veresgyuri/fanoe-tester/images/20260712_092536.jpg

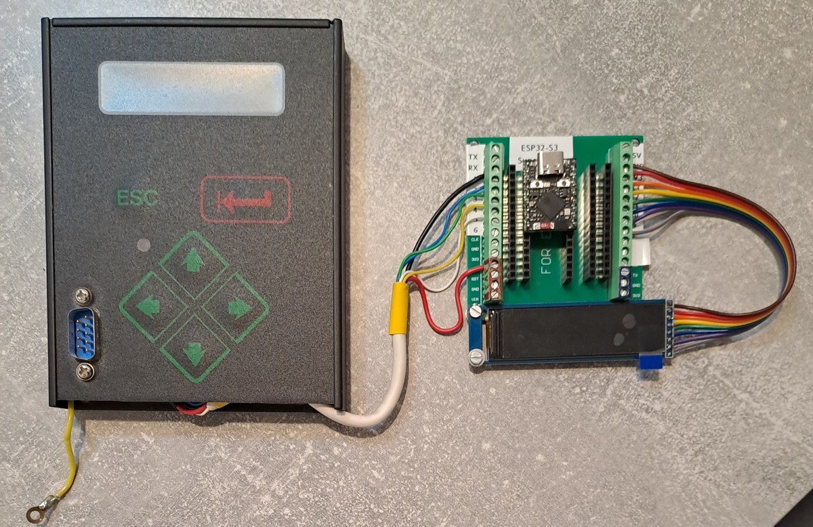
images/20260712_092536.jpg
