veresgyuri/fanoe-tester/images/pin_esp32_s3_super_mini.jpg

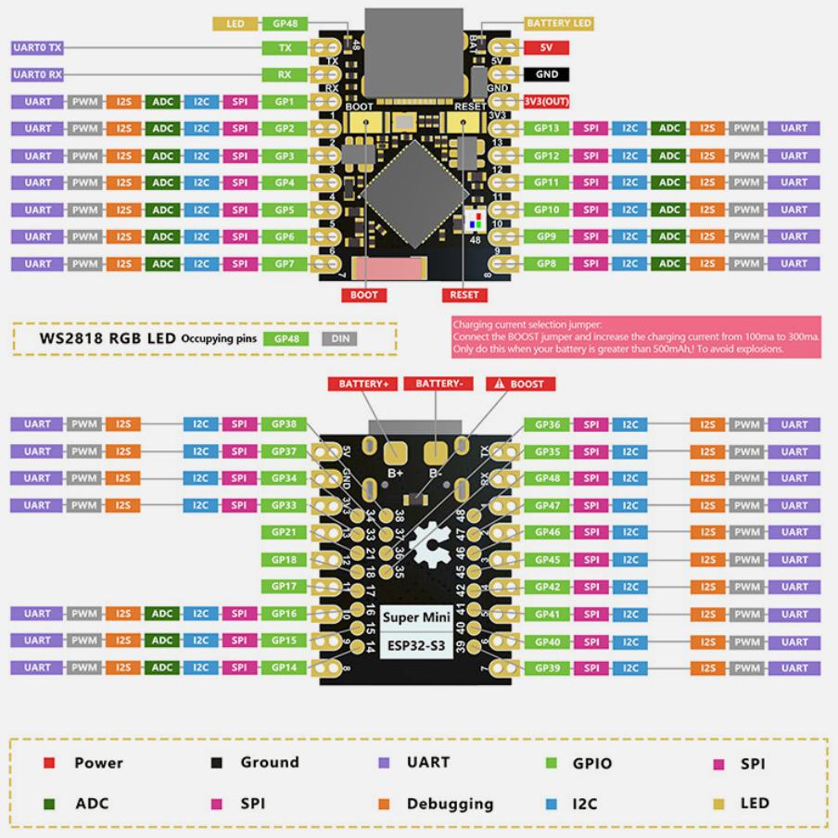
images/pin_esp32_s3_super_mini.jpg
