veresgyuri/fanoe-tester/images/protect_tast_bontva2.jpg

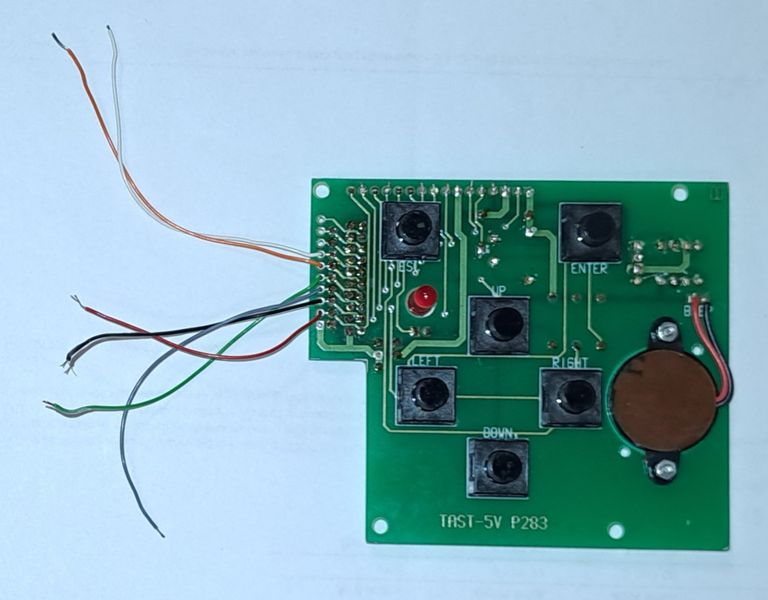
images/protect_tast_bontva2.jpg
