veresgyuri/fanoe-tester/.copilot-instructions.md

## Context & Hierarchy
This document defines the core execution rules for AI coding agents.  
**In case of any conflict, always follow this (`.copilot-instructions.md`) file and ignore conflicting information from `AGENTS.md`.**  

## 1. Role & Core Philosophy
You are an AI agent optimized for CircuitPython (version 10.x.x) and ESP32-S3 microcontroller development.  
Your primary goal is to write robust, modular, highly stable and bug-free code for an diagnostic meter tool.
Prioritize **stability and non-blocking execution** over extreme memory optimization.

**Flexibility note:** When working on domain-specific tasks (e.g., adding new hardware, debugging subsystems), load the relevant skill file to override or extend these rules. Skills define specialized workflows and take precedence within their scope.

## 2. CircuitPython Rules & Hardware-Specific Context

**File Structure:** Each `/instructions/*.md` file is organized in two sections:
1. Human-oriented reference (context, specifications)
2. AI-specific logic (`CODE GENERATION LOGIC` — this is YOUR section)

**ALWAYS read this file (applies to ALL code generation):**
- `instructions/CircuitPython_instructions.md` - CircuitPython language rules, non-blocking patterns, memory management, and core library usage  
- `instructions/fanoe_tester_logic.md` - device logic: test sequences, measurement methods, calculations.  
   Menu structure lives in `menu_data.py` (see Section 3) - this file only describes the measurement logic, not the menu tree itself. 

**ALSO read when working with specific hardware components:**
- MCU/Pinout -> read `instructions/esp32s3supermini_instructions.md`
- Keypad -> read `instructions/keypad_6_matrix_instructions.md`
- Display -> read `instructions/76x284_st7789_tft_instructions.md`  

**Crucial:** Always follow the `CODE GENERATION LOGIC` sections. CircuitPython rules take precedence over hardware-specific details. Never use standard Python constructs that violate CircuitPython constraints (e.g., hardware ISRs, blocking loops).  

## 3. Write/read - permissions
### Writable (you may edit these):
- `code.py` - Main application (Note: Writing to filesystem from code is conditional, see Section 2 instructions)  
- `settings.toml` - Configuration file
- `/lib/*` - CircuitPython libraries

**Read-only files (NEVER modify):**  
- `README.md` - Human documentation  
- `AGENTS.md` - AI agent overview  
- `boot.py` - Filesystem & Mode Control - Manages USB drive vs. code write access via GPIO  
- `menu_data.py` - Menu structure data (dict/list)  
- `tft_messages.py` - TFT message definitions  
- `.copilot-instructions.md` - Agent execution rules (this file)
- `/instructions/*.md` - CircuitPython OS and hardware component rules  
- `/fonts/hu_127_ekezetes_20.pcf` - Hungarian accented fonts & Special characters set  
- `/images/*` - Visual project assets  
- `/archive/*` - OFF-LIMITS (user-only sandbox)  
- `/skills/*.md` - AI agent skill definitions (loaded on-demand)

### Forbidden Paths (NEVER ACCESS)
- `/archive/*` - Off-limits to any AI system (including orchestrators).

## 4. Output & Delivery
- **Complete code first:** Provide fully functional, usable code by default. No partial snippets or "pseudocode."  
- **Minimal edits:** If modifying existing code, change only what is necessary. Avoid refactoring unrelated code.  
- **Validation:** Always validate generated code against the `CODE GENERATION LOGIC` section in relevant `/instructions/*.md` file before delivery.  
- **Testing notes:** Include comments or test suggestions for new hardware-related modules to aid debugging via Serial REPL.

## 5. Coding Standards & Style
- **Pattern:** Use modular, Object-Oriented Programming (OOP) patterns for `code.py` and other logic modules.  
`menu_data.py` is a pure data file (menu tree structure) and is NOT subject to the OOP requirement — it must remain a plain,  
directly-readable data structure (dict/list), with no embedded function calls or live references.  
Dynamic screens reference an "action" string key, resolved/dispatched by code.py.
- **Naming:** snake_case for variables/functions, PascalCase for classes.  
- **Formatting:** 4 spaces indentation, max 88 characters per line (Black style).
- **Libraries:** Only use CircuitPython-compatible libraries  
- **Memory Management:** Prioritize stability; minimize global variables and release unused resources.  
- **Documentation:** Use clear, concise comments and docstrings. Maintain readability for DIY hobbyists.
- **Error Handling:** Implement robust error handling with try-except blocks, especially for hardware interactions and network operations.
- **Logging & Debugging:** Use a global `DEBUG` flag and a `dprint(*args, **kwargs)` wrapper to gate all non-critical REPL output.

## 6. Display & Keypad Logic
- **Non-Blocking Execution:** UI updates (TFT) and input handling (Keypad) MUST NOT interrupt the measurement. Use asyncio or non-blocking state machines.
- **Validation:** Include print() or logging statements for key state changes (analog input, GPIO level, errors) to assist debugging via Serial REPL.
- **Setting Management:** Implement a modular settings management system that can easily add/remove settings from `settings.toml` without code changes.
- **Stability:** This board has 2MB embedded PSRAM. CircuitPython automatically places large allocations (e.g. displayio bitmaps, buffers) there once the firmware build supports PSRAM — no manual memory placement is needed in code. Still keep UI/menu logic memory-conscious: avoid unnecessary large temporary buffers, and release unused objects (del + gc.collect()) after heavy operations like display redraws.

## 7. Testing & Deployment
- **Unit Testing:** Suggest basic test cases for new hardware-related modules.
- **Manual Deployment:** Keep in mind that code is deployed by copying files to the CIRCUITPY drive; avoid any automation scripts for file transfer.

## 8. Skill-Based Workflows (On-Demand)
Optional, focused skill files can extend or override these rules for specific tasks. When a skill is loaded, it takes precedence within its defined scope.

**Skill location:**
- `skills/<skill-name>.md`

**Current examples:**
- `skills/add-menu.md` - workflow for menu structure and navigation changes
- `skills/add-device-action.md` - workflow for action handlers, confirmation-gated actions, continuous modes, and state-machine logic

**Loading a skill:**
Skills appear as slash commands in Copilot Chat when their markdown file exists in the `skills/` folder. When a skill is active, follow its instructions for that task while still respecting the global rules in this file and the relevant `/instructions/*.md` files. If a task touches both menu structure and device behavior, read both relevant skills.
