veresgyuri/fanoe-tester/images/fanoe_tester_logic_1v0.jpg

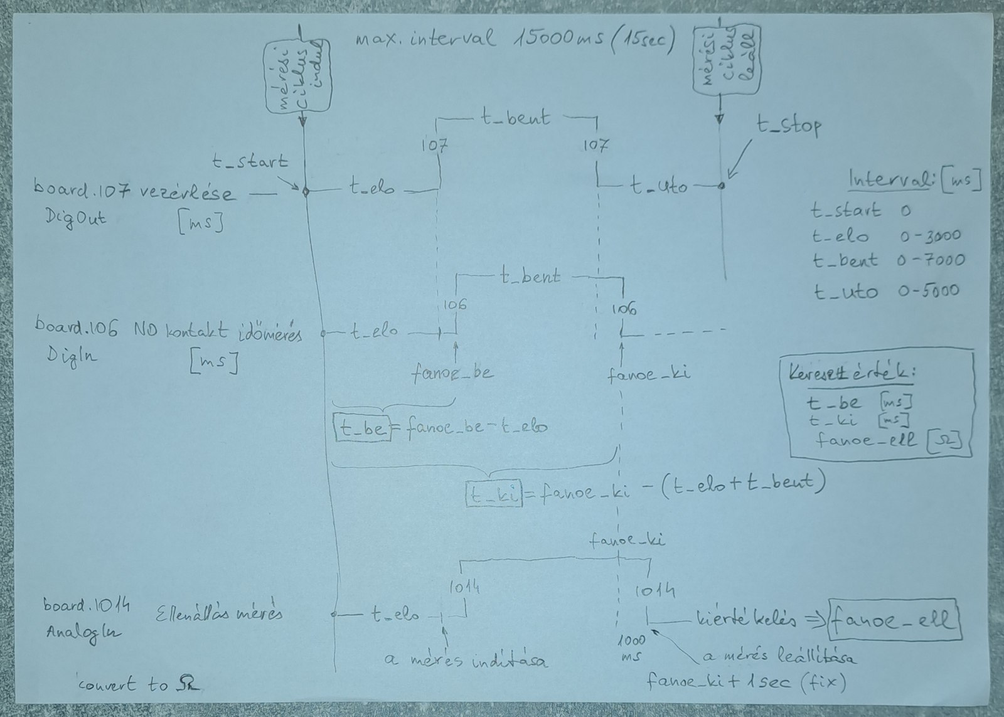
images/fanoe_tester_logic_1v0.jpg
