veresgyuri/fanoe-tester/KiCad/FANOE_tester_1v0.kicad_pcb

## KiCad design KiCad/FANOE_tester_1v0.kicad_pcb (2026-09-26)

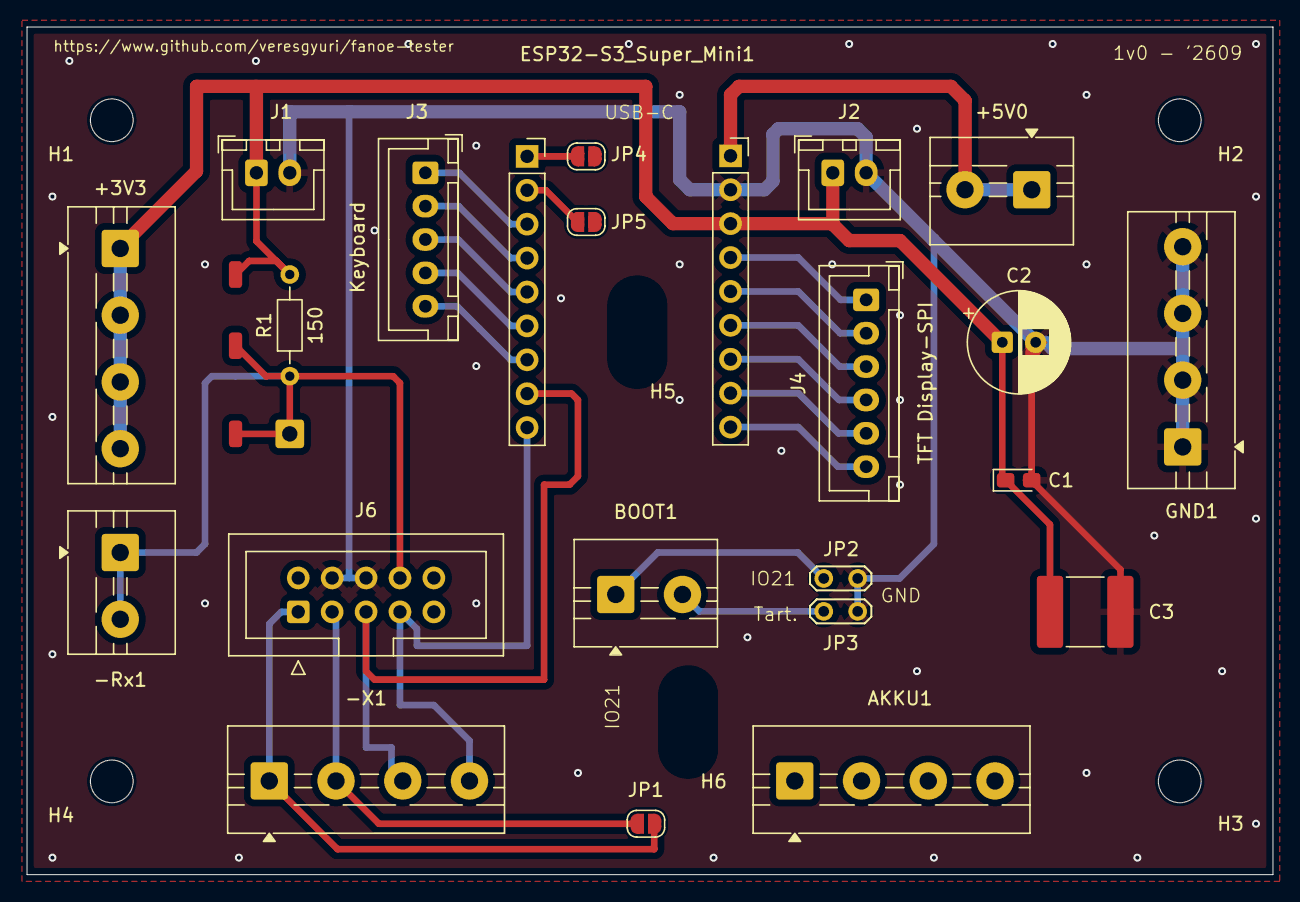
[picture p14: board FANOE_tester_1v0.kicad_pcb from above]

Board: 2 copper layers, 93.3 x 63.5 mm, 33 parts (0 on the bottom side), 23 nets.

Parts:
+3V3: Screw_Terminal_01x04; TerminalBlock_MaiXu_MX126-5.0-04P_1x04_P5.00mm
+5V0: Screw_Terminal_01x02; TerminalBlock_MaiXu_MX126-5.0-02P_1x02_P5.00mm
-Rx1: Screw_Terminal_01x02; TerminalBlock_MaiXu_MX126-5.0-02P_1x02_P5.00mm
-X1: Screw_Terminal_01x04; TerminalBlock_MaiXu_MX126-5.0-04P_1x04_P5.00mm
AKKU1: Screw_Terminal_01x04; TerminalBlock_MaiXu_MX126-5.0-04P_1x04_P5.00mm
BOOT1: Screw_Terminal_01x02; TerminalBlock_MaiXu_MX126-5.0-02P_1x02_P5.00mm
C1: C_Polarized_Small; CP_EIA-2012-12_Kemet-R_HandSolder
C2: CP_Radial_D7.5mm_P2.50mm
C3: C_Small; C_2220_5750Metric_Pad1.97x5.40mm_HandSolder
ESP32-S3_Super_Mini1, ESP32-S3_Super_Mini2: Conn_01x09; PinSocket_1x09_P2.54mm_Vertical
GND1: Screw_Terminal_01x04; TerminalBlock_MaiXu_MX126-5.0-04P_1x04_P5.00mm
H1, H2, H3, H4, H5, H6: MountingHole_3.2mm_M3
J1, J2: Conn_01x02; JST_XH_B2B-XH-A_1x02_P2.50mm_Vertical
J3: Keyboard; JST_XH_B5B-XH-A_1x05_P2.50mm_Vertical
J4: TFT Display-SPI; JST_XH_B6B-XH-A_1x06_P2.50mm_Vertical
J6: Conn_02x05_Odd_Even; IDC-Header_2x05_P2.54mm_Vertical
JP1, JP4, JP5: SolderJumper_2_Open; SolderJumper-2_P1.3mm_Open_RoundedPad1.0x1.5mm
JP2, JP3: Jumper_2_Open; TestPoint_2Pads_Pitch2.54mm_Drill0.8mm
Ohm1: SolderWire-0.5sqmm_1x01_D0.9mm_OD2.1mm
Ohm2, Ohm3, Ohm4: SolderWirePad_1x01_SMD_1x2mm
R1: 150; R_Axial_DIN0204_L3.6mm_D1.6mm_P7.62mm_Horizontal

Connections:
-3V3: +3V3.1, +3V3.2, +3V3.3, +3V3.4, C1.1, C2.1, C3.1, ESP32-S3_Super_Mini2.3 (+3V3-), J1.1, J2.1, Ohm4.1, R1.2
GND: C1.2, C2.2, C3.2, ESP32-S3_Super_Mini2.2 (GND-), GND1.1, GND1.2, GND1.3, GND1.4, J1.2, J2.2, J6.4, J6.6, JP2.2 (B), JP3.2 (B)
unnamed: +5V0.1, +5V0.2, ESP32-S3_Super_Mini2.1 (+5V-)
unnamed: -Rx1.1, -Rx1.2, J6.8, Ohm1.1, Ohm2.1, Ohm3.1, R1.1
unnamed: -X1.1, J6.1, JP1.2 (B)
unnamed: -X1.2, J6.3, JP1.1 (A)
unnamed: -X1.3, ESP32-S3_Super_Mini1.8 (-IO6), J6.5
unnamed: -X1.4, ESP32-S3_Super_Mini1.9 (-IO7), J6.7
unnamed: BOOT1.1, JP2.1 (A)
unnamed: BOOT1.2, JP3.1 (A)
unnamed: ESP32-S3_Super_Mini1.3 (-IO1), J3.1 (Column1-)
unnamed: ESP32-S3_Super_Mini1.4 (-IO2), J3.2 (Column2-)
unnamed: ESP32-S3_Super_Mini1.5 (-IO3), J3.3 (Column3-)
unnamed: ESP32-S3_Super_Mini1.6 (-IO4), J3.4 (Row1-)
unnamed: ESP32-S3_Super_Mini1.7 (-IO5), J3.5 (Row2-)
unnamed: ESP32-S3_Super_Mini1.2 (-RX), JP5.1 (A)
unnamed: ESP32-S3_Super_Mini1.1 (-TX), JP4.1 (A)
unnamed: ESP32-S3_Super_Mini2.9 (IO8-), J4.6 (-BL)
unnamed: ESP32-S3_Super_Mini2.8 (IO9-), J4.5 (-CS)
unnamed: ESP32-S3_Super_Mini2.7 (IO10-), J4.4 (-DC)
unnamed: ESP32-S3_Super_Mini2.6 (IO11-), J4.3 (-RST)
unnamed: ESP32-S3_Super_Mini2.5 (IO12-), J4.2 (-SDA)
unnamed: ESP32-S3_Super_Mini2.4 (IO13-), J4.1 (-SCL)
