veresgyuri/fanoe-tester/(commit log)

2026-07-29 Add a circuit diagram to section 2
2026-07-30 0v4 Relay action-IO7 ready for use
2026-07-30 Add circuit diagram and human informations
2026-08-01 0v72-ESC no-op TFT figyelmeztető üzenet a főmenüben nyomott ESC-re, vagy LEFT gombra.
2026-08-02 0v82 t_ki mérés, csak ha volt t_be
2026-08-06 0v86 T_BENT alatti "korai elengedés" TFT hibaüzenet korrigálva.
    [code.py]
2026-08-07 0v96 PWM adjust for 9 steps
2026-08-08 0v97 Hibajavitas: stale setting-key hosszu ESC utan, blokkolo sleep a mentesnel, fenyero-elonezet visszaallitasa
2026-08-13 fix(ohm-meter): improve open circuit detection logic
    Update the `OhmMeter` class to better handle floating input pins. Since the hardware lacks a pull-up resistor on IO14, the ADC value stabilizes around a specific midpoint rather than approaching V_ref when the circuit is open.
    - Implement detection for floating ADC values using a center value and tolerance.
    - Increase `OPEN_CIRCUIT_MARGIN_V` to 0.5V.
    - Add documentation regarding the lack of hardware pull-up resistor on IO14.
    - Update the TFT message for open circuits to include "szakadás" (break/open).
    - Minor version string adjustment.
    [code.py, tft_messages.py]
2026-08-13 refactor(adc): centralize floating pin detection constants
    Move ADC floating point detection constants from the `OhmMeter` class
    to the module level to allow shared use between `OhmMeter` and
    `FanoeMeasurementCycle`.
    - Relocate `ADC_FLOATING_RAW_CENTER` and `ADC_FLOATING_RAW_TOLERANCE`
    to global scope.
    - Update `OhmMeter.read_ohms` to use the new global constants.
    - Update `FanoeMeasurementCycle._read_ohms` to implement floating
    point detection using the centralized constants.
    - Update version to 0v99.
2026-08-13 feat(ui): implement font glyph preloading to prevent menu lag
    Introduces a mechanism to pre-collect all unique characters used in the
    menu tree, runtime messages, and common symbols. These characters are
    preloaded into the display font during startup via `Display.preload_glyphs`.
    This prevents the "character-by-character" rendering delay previously
    caused by the lazy loading of glyphs from flash memory during the first
    time a menu item or message was accessed.
    Also includes minor cleanup of `_read_ohms` logic and version bump to 1v00.
    [code.py]
2026-08-13 chore(core): bump version to 1v01 and decouple fanoe_ell locking
    Updates the version number and modifies the `FanoeMeasurementCycle` logic
    to anchor the `fanoe_ell` locking period to the start of the `T_BENT`
    phase (`_t_bent_start`) rather than the `fanoe_be_time`.
    This change ensures that the resistance measurement window is
    intentionally independent of the IO6 contact logic, adhering to the
    principle that measurement must run separately from contact detection.
2026-08-14 fix(ohm-meter): implement floating node exclusion and improve result priority
    Introduce a specific resistance range (130-180 Ω) to identify and exclude
    floating IO14 nodes during the measurement cycle, preventing false
    readings in the gap between known Fanoe resistance ranges.
    Additionally:
    - Update RelayControl logic to invert pin polarity (active low).
    - Adjust display priority to favor valid `fanoe_ell` readings over
    `fanoe_szakadt` flags to prevent transient open circuits from
    overwriting stable measurements.
    - Bump version to 1v02.
    - Fix minor whitespace in `value_szakadt` message.
    [code.py, tft_messages.py]
2026-08-14 1v10 fix(ohm-meter): improve open circuit detection logic
    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
    [code.py, menu_data.py, tft_messages.py]
2026-08-15 chore: bump version to 1v11
    Implement high-precision timing for manual hold detection using
    nanosecond-resolution monotonic clocks to eliminate quantization errors.
    The update introduces:
    - Immediate relay activation upon ENTER press to minimize latency.
    - A high-speed polling loop (up to 200ms timeout) to detect the exact
    moment the contact closes.
    - Decoupling of the UI update interval from the contact detection
    logic, ensuring the contact pull-in time is captured with
    microsecond-level accuracy regardless of the 50ms TFT refresh rate.
    [code.py]
2026-08-16 chore: bump version to 1v14
    Update version to 1v14 and implement high-precision edge detection for
    manual hold functionality.
    The manual hold timing logic has been refactored to use a high-frequency
    polling interval (500 µs) to ensure accurate detection of IO6 edge
    transitions, independent of the main loop overhead. This includes
    implementing a timeout mechanism and a cosmetic update flag to ensure
    that display and LED updates (which involve slower SPI communication)
    do not interfere with the timing measurements.
    [code.py]
2026-08-16 1v16 (1v15 deleted) feat(logic): improve timing precision for Fanoe measurement cycles
    Refactor the timing calculation logic to anchor measurements to actual
    relay state transitions (IO7 ON/OFF) rather than nominal target
    durations. This ensures higher accuracy for t_be, t_ki, r_be, and r_ki
    measurements.
    Additionally, implement a high-speed polling window for contact
    detection during the measurement cycle to capture the exact moment of
    contact, while maintaining a safe timeout to prevent blocking the
    main loop and impacting ESC response or Ohm measurements.
    - Update version to 1v16
    - Add `_t_bent_start` and `_t_uto_start` for precise timing anchors
    - Implement `CYCLE_CONTACT_POLL_INTERVAL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
    [code.py]
2026-08-23 WS2812 LED do not use from ver: 1v2+
2026-08-23 - Update `VERSION` to 1v2 refactor: remove WS2812 status LED and optimize resources
    Remove the `StatusLed` class and associated `neopixel` dependency to
    streamline the application. This change shifts status feedback
    exclusively to the TFT display, reducing hardware complexity and
    improving memory management through better RAM and GC optimization.
    - Remove `neopixel` import and `StatusLed` class
    - Remove `STATUS_LED_PIN` and color constants
    - Clean up `FanoeTesterApp` initialization and manual hold logic
2026-08-23 1v31 and refactor information action handlers refactor(ui): decouple info screen headers from hardcoded strings
    Update the version to 1v31 and refactor information action handlers
    to dynamically retrieve header text from the current menu item's
    screen property. This eliminates redundant static string definitions
    across multiple info handlers (CPU, RAM, Flash, etc.) and ensures
    consistency with the menu data.
2026-08-23 chore(config): bump version to 1v32 and dynamicize ohm meter header
    Update the VERSION constant to 1v32.
    Refactor the ohm meter mode display to retrieve its header text
    dynamically from the current menu item's screen property instead of
    using a hardcoded string, ensuring consistency with the recent
    refactoring of information action handlers.
2026-08-26 refactor: simplify keypad logic and remove ESC long press functionality
    Bump version to 1v40. Remove long press detection from the Keypad class
    and eliminate the `jump_to_root` method in MenuNavigator. This change
    removes the long ESC press behavior, allowing ESC and LEFT to trigger
    immediate navigation back.
2026-08-27 1v41 refactor navigation and lock R_ELL_OHM threshold
    - Remove long-press ESC detection; make ESC and LEFT respond instantly on press
    - Simplify Keypad and MenuNavigator by removing duration tracking and jump_to_root()
    - Set R_ELL_OHM to a fixed constant (80 Ohm) in code.py and remove it from settings.toml
2026-09-26 1st KiCad & JLCPCB for the prototype PCB
